cuongcodeF4/Swarm_quadcopter-/flow chart.png

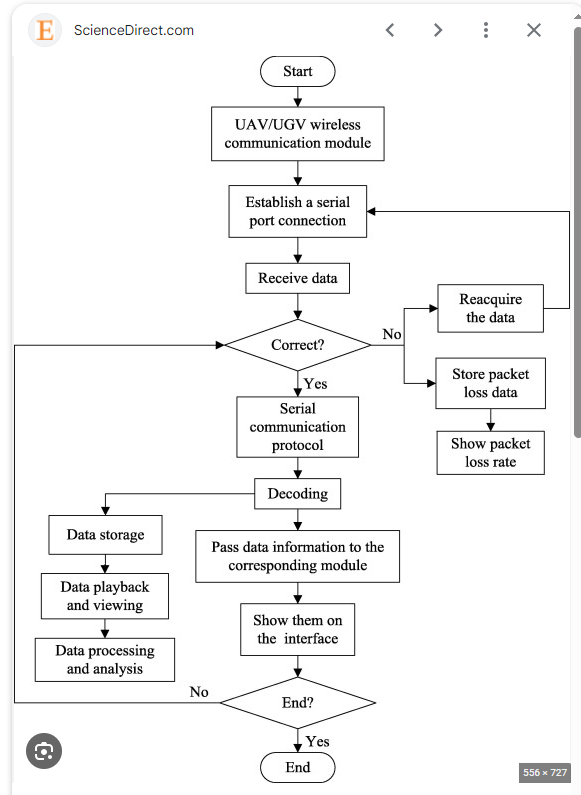
flow chart.png
