cuongcodeF4/Swarm_quadcopter-/pymavlink/listen.py

from pymavlink import mavutil

# Start a connection listening on a UDP port
the_connection = mavutil.mavlink_connection('udp:172.30.144.1:14550')

# Wait for the first heartbeat 
#   This sets the system and component ID of remote system for the link
the_connection.wait_heartbeat()
print("Heartbeat from system (system %u component %u)" % (the_connection.target_system, the_connection.target_component))

# while True:
#     msg = the_connection.recv_match(type= "ATTITUDE",blocking = True)
#     print(msg)
