cuongcodeF4/Swarm_quadcopter-/(commit log)

2023-12-16 - Add demo, which use pymavlink to send command between Raspberry PI and Drone SITL
2024-01-19 Update MQTT msg protocol to What to do.txt
    thêm các protocol cần thiết để việc đồng bộ drone được nhanh chóng và dễ, có thể apply cho nhiều dạng connection protocol khác chứ không stuck với MQTT
2024-04-14 Add prototype UI for system drone
2024-04-21 Fixed problem the ui was frezon when push the STOP button
2024-05-05 Add battery status for each drone
2024-05-05 add feature update battery and decode BAT from master side
2024-05-05 update status battery drone
2024-05-05 update show battery status
2024-06-13 Raspberry Cuong push code
